gradesta/readable-steno/StenoKiCadProject/production/bom.csv

Designator | Footprint | Quantity | Value | LCSC Part #
C1 | 1206 | 1 | C
D1, D10, D11, D12, D13, D14, D15, D16, D17, D18, D19, D2, D20, D21, D22, D23, D24, D25, D26, D27, D28, D29, D3, D30, D4, D5, D6, D7, D8, D9 | 1206 | 30 | Diode
D31, D32, D33, D34, D35, D36, D37, D38, D39, D40, D41, D42, D43, D44, D45, D46, D47, D48, D49, D50, D51, D52, D53, D54, D55, D56, D57, D58, D59, D60 | 1206 | 30 | LED
J1 | PinHeader_1x04_P2.54mm_Vertical | 1 | Conn_01x04_Pin
R1, R10, R11, R12, R13, R14, R15, R16, R17, R18, R19, R2, R20, R21, R22, R23, R24, R25, R26, R27, R28, R29, R3, R30, R33, R4, R5, R6, R7, R8, R9 | 1206 | 31 | Resistor
S1, S10, S11, S12, S13, S14, S15, S16, S17, S18, S19, S2, S20, S21, S22, S23, S24, S25, S26, S27, S28, S29, S3, S30, S4, S5, S6, S7, S8, S9 | Hotswap_Choc_V1 | 30 | Keyswitch
U1 | RP2040_Pro_Micro | 1 | RP2040_Pro_Micro
U2, U3, U4, U5 | DIP-16_W7.62mm | 4 | 74HC595
