gradesta/readable-steno/StenoKiCadProject/StenKeyboard.kicad_pcb

## KiCad design StenoKiCadProject/StenKeyboard.kicad_pcb (2026-01-27)

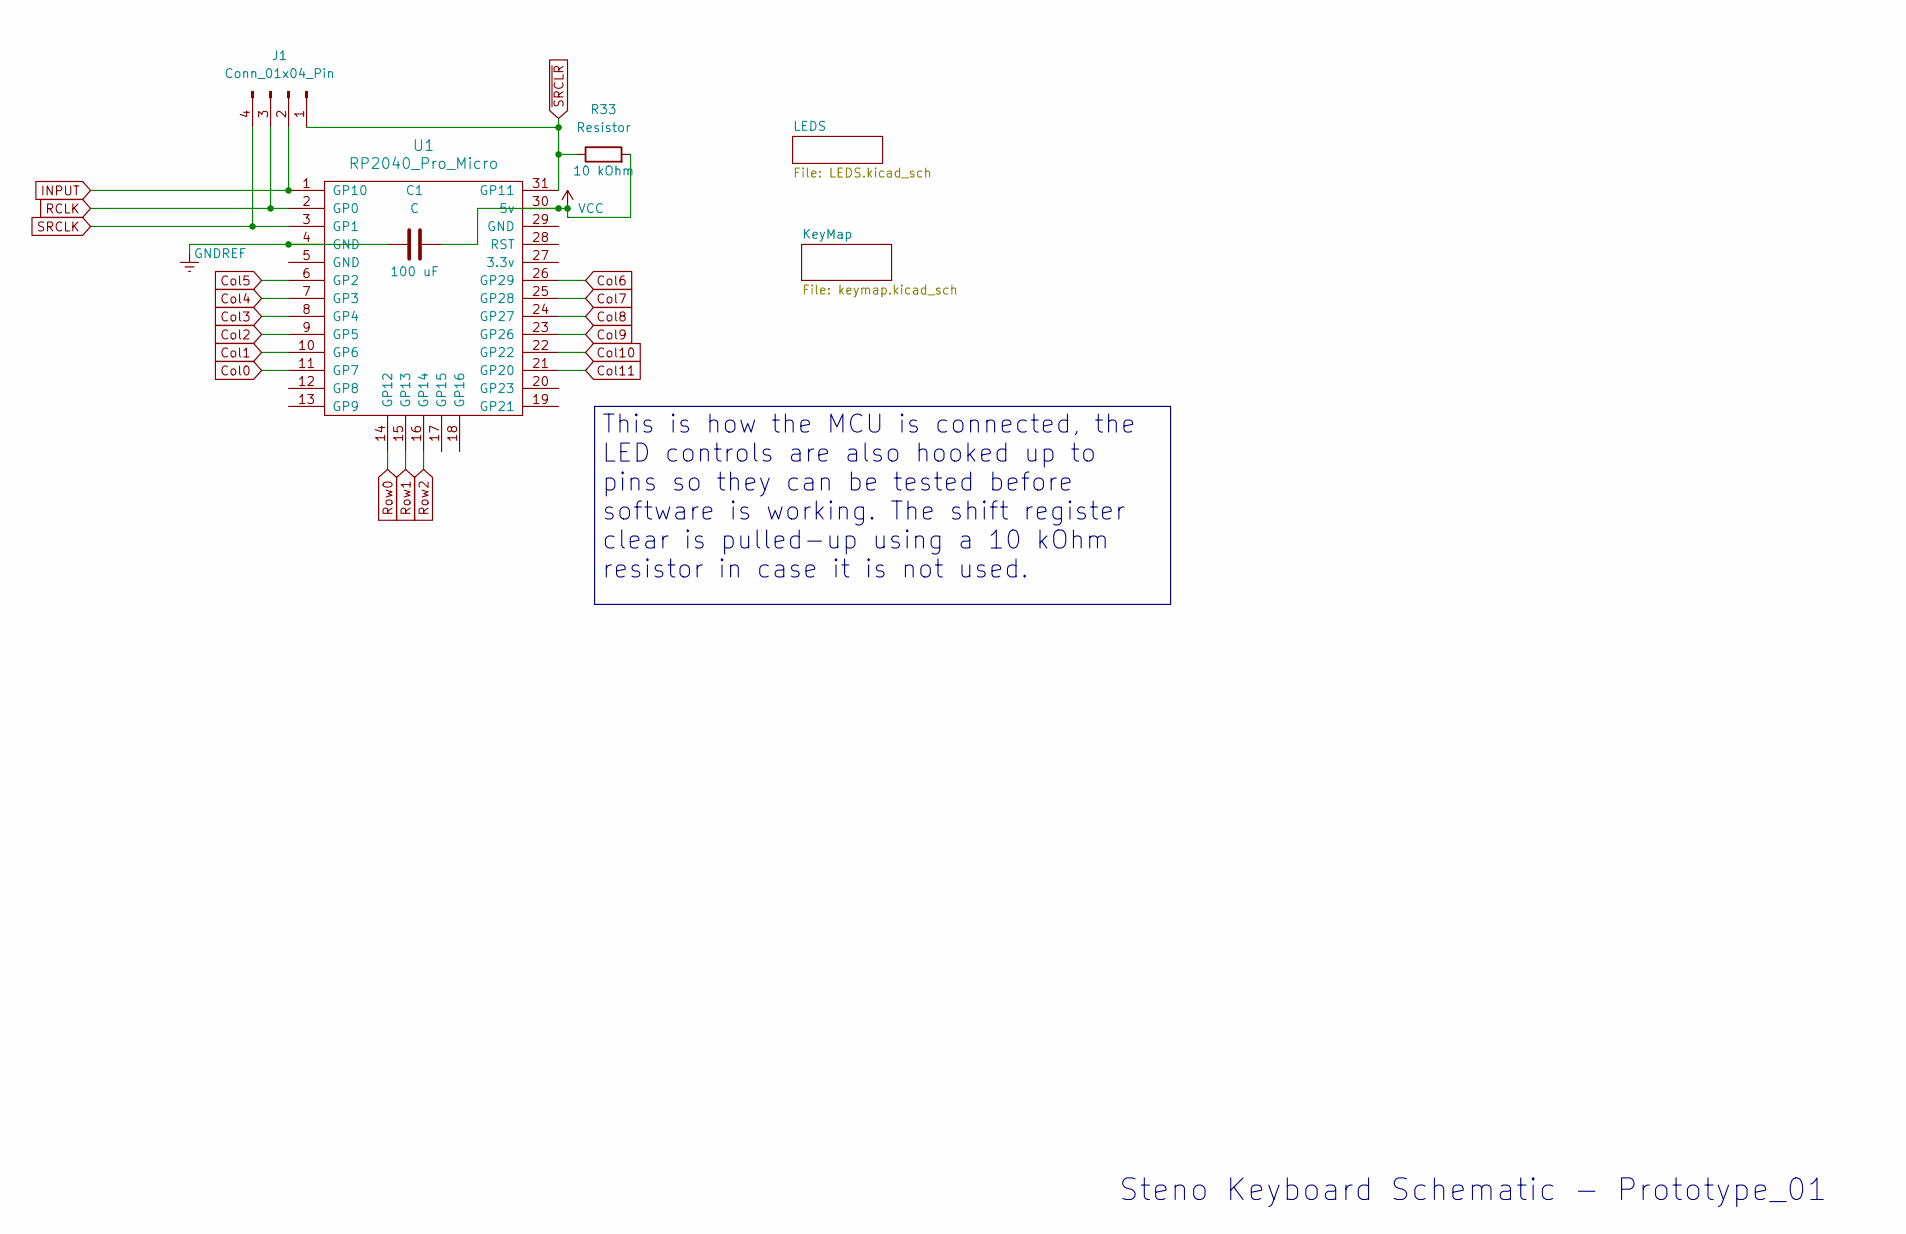
[picture p1: schematic StenKeyboard.kicad_sch]

Parts:
C1: C; C_1206_3216Metric
J1: Conn_01x04_Pin; PinHeader_1x04_P2.54mm_Vertical
R33: Resistor; R_1206_3216Metric
U1: RP2040_Pro_Micro

Connections:
Col0: U1.11 (GP7); also elsewhere on the board
Col1: U1.10 (GP6); also elsewhere on the board
Col2: U1.9 (GP5); also elsewhere on the board
Col3: U1.8 (GP4); also elsewhere on the board
Col4: U1.7 (GP3); also elsewhere on the board
Col5: U1.6 (GP2); also elsewhere on the board
Col6: U1.26 (GP29); also elsewhere on the board
Col7: U1.25 (GP28); also elsewhere on the board
Col8: U1.24 (GP27); also elsewhere on the board
Col9: U1.23 (GP26); also elsewhere on the board
Col10: U1.22 (GP22); also elsewhere on the board
Col11: U1.21 (GP20); also elsewhere on the board
GNDREF: C1.1, U1.4 (GND); also elsewhere on the board
INPUT: J1.2, U1.1 (GP10); also elsewhere on the board
RCLK: J1.3, U1.2 (GP0); also elsewhere on the board
Row0: U1.14 (GP12); also elsewhere on the board
Row1: U1.15 (GP13); also elsewhere on the board
Row2: U1.16 (GP14); also elsewhere on the board
SRCLK: J1.4, U1.3 (GP1); also elsewhere on the board
VCC: C1.2, R33.2, U1.30 (5v); also elsewhere on the board
~SRCLR: J1.1, R33.1, U1.31 (GP11); also elsewhere on the board

Notes on the sheet:
Steno Keyboard Schematic - Prototype_01
This is how the MCU is connected, the LED controls are also hooked up to pins so they can be tested before software is working. The shift register clear is pulled-up using a 10 kOhm resistor in case it is not used.

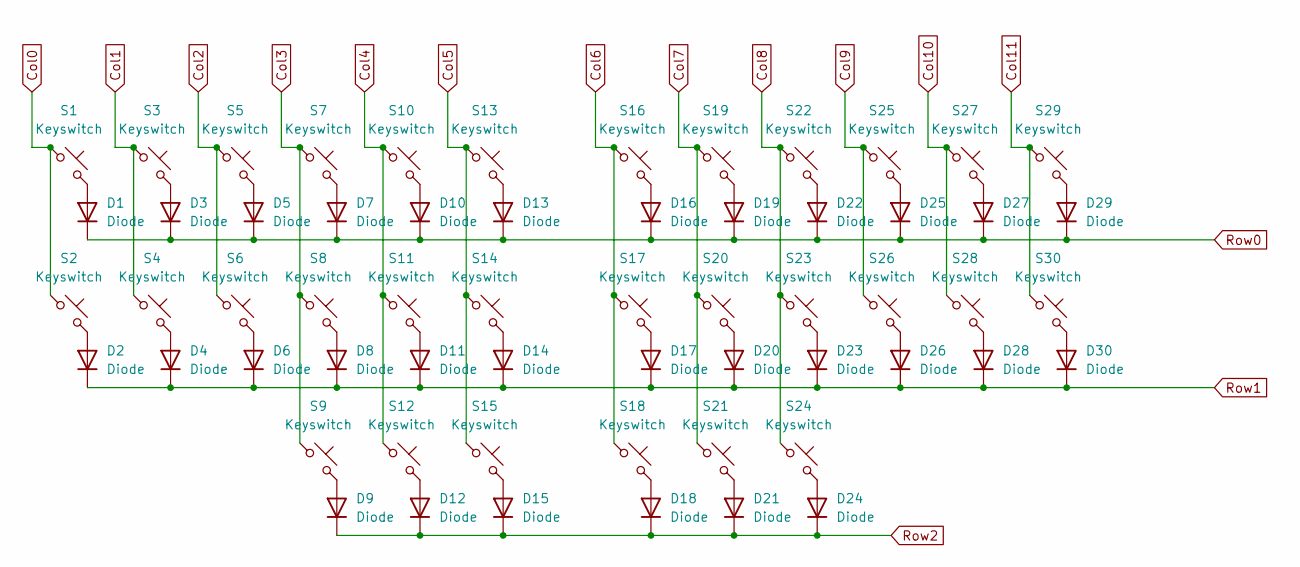
[picture p2: schematic keymap.kicad_sch]

Parts:
D1, D2, D3, D4, D5, D6, D7, D8, D9, D10, D11, D12, D13, D14, D15, D16, D17, D18, D19, D20, D21, D22, D23, D24, D25, D26, D27, D28, D29, D30: Diode; D_1206_3216Metric
S1, S2, S3, S4, S5, S6, S7, S8, S9, S10, S11, S12, S13, S14, S15, S16, S17, S18, S19, S20, S21, S22, S23, S24, S25, S26, S27, S28, S29, S30: Keyswitch; Hotswap_Choc_V1

Connections:
Col0: S1.1, S2.1; also elsewhere on the board
Col1: S3.1, S4.1; also elsewhere on the board
Col2: S5.1, S6.1; also elsewhere on the board
Col3: S7.1, S8.1, S9.1; also elsewhere on the board
Col4: S10.1, S11.1, S12.1; also elsewhere on the board
Col5: S13.1, S14.1, S15.1; also elsewhere on the board
Col6: S16.1, S17.1, S18.1; also elsewhere on the board
Col7: S19.1, S20.1, S21.1; also elsewhere on the board
Col8: S22.1, S23.1, S24.1; also elsewhere on the board
Col9: S25.1, S26.1; also elsewhere on the board
Col10: S27.1, S28.1; also elsewhere on the board
Col11: S29.1, S30.1; also elsewhere on the board
unnamed: D1.2 (A), S1.2
unnamed: D2.2 (A), S2.2
unnamed: D3.2 (A), S3.2
unnamed: D4.2 (A), S4.2
unnamed: D5.2 (A), S5.2
unnamed: D6.2 (A), S6.2
unnamed: D7.2 (A), S7.2
unnamed: D8.2 (A), S8.2
unnamed: D9.2 (A), S9.2
unnamed: D10.2 (A), S10.2
unnamed: D11.2 (A), S11.2
unnamed: D12.2 (A), S12.2
unnamed: D13.2 (A), S13.2
unnamed: D14.2 (A), S14.2
unnamed: D15.2 (A), S15.2
unnamed: D16.2 (A), S16.2
unnamed: D17.2 (A), S17.2
unnamed: D18.2 (A), S18.2
unnamed: D19.2 (A), S19.2
unnamed: D20.2 (A), S20.2
unnamed: D21.2 (A), S21.2
unnamed: D22.2 (A), S22.2
unnamed: D23.2 (A), S23.2
unnamed: D24.2 (A), S24.2
unnamed: D25.2 (A), S25.2
unnamed: D26.2 (A), S26.2
unnamed: D27.2 (A), S27.2
unnamed: D28.2 (A), S28.2
unnamed: D29.2 (A), S29.2
unnamed: D30.2 (A), S30.2
Row0: D1.1 (K), D3.1 (K), D5.1 (K), D7.1 (K), D10.1 (K), D13.1 (K), D16.1 (K), D19.1 (K), D22.1 (K), D25.1 (K), D27.1 (K), D29.1 (K); also elsewhere on the board
Row1: D2.1 (K), D4.1 (K), D6.1 (K), D8.1 (K), D11.1 (K), D14.1 (K), D17.1 (K), D20.1 (K), D23.1 (K), D26.1 (K), D28.1 (K), D30.1 (K); also elsewhere on the board
Row2: D9.1 (K), D12.1 (K), D15.1 (K), D18.1 (K), D21.1 (K), D24.1 (K); also elsewhere on the board

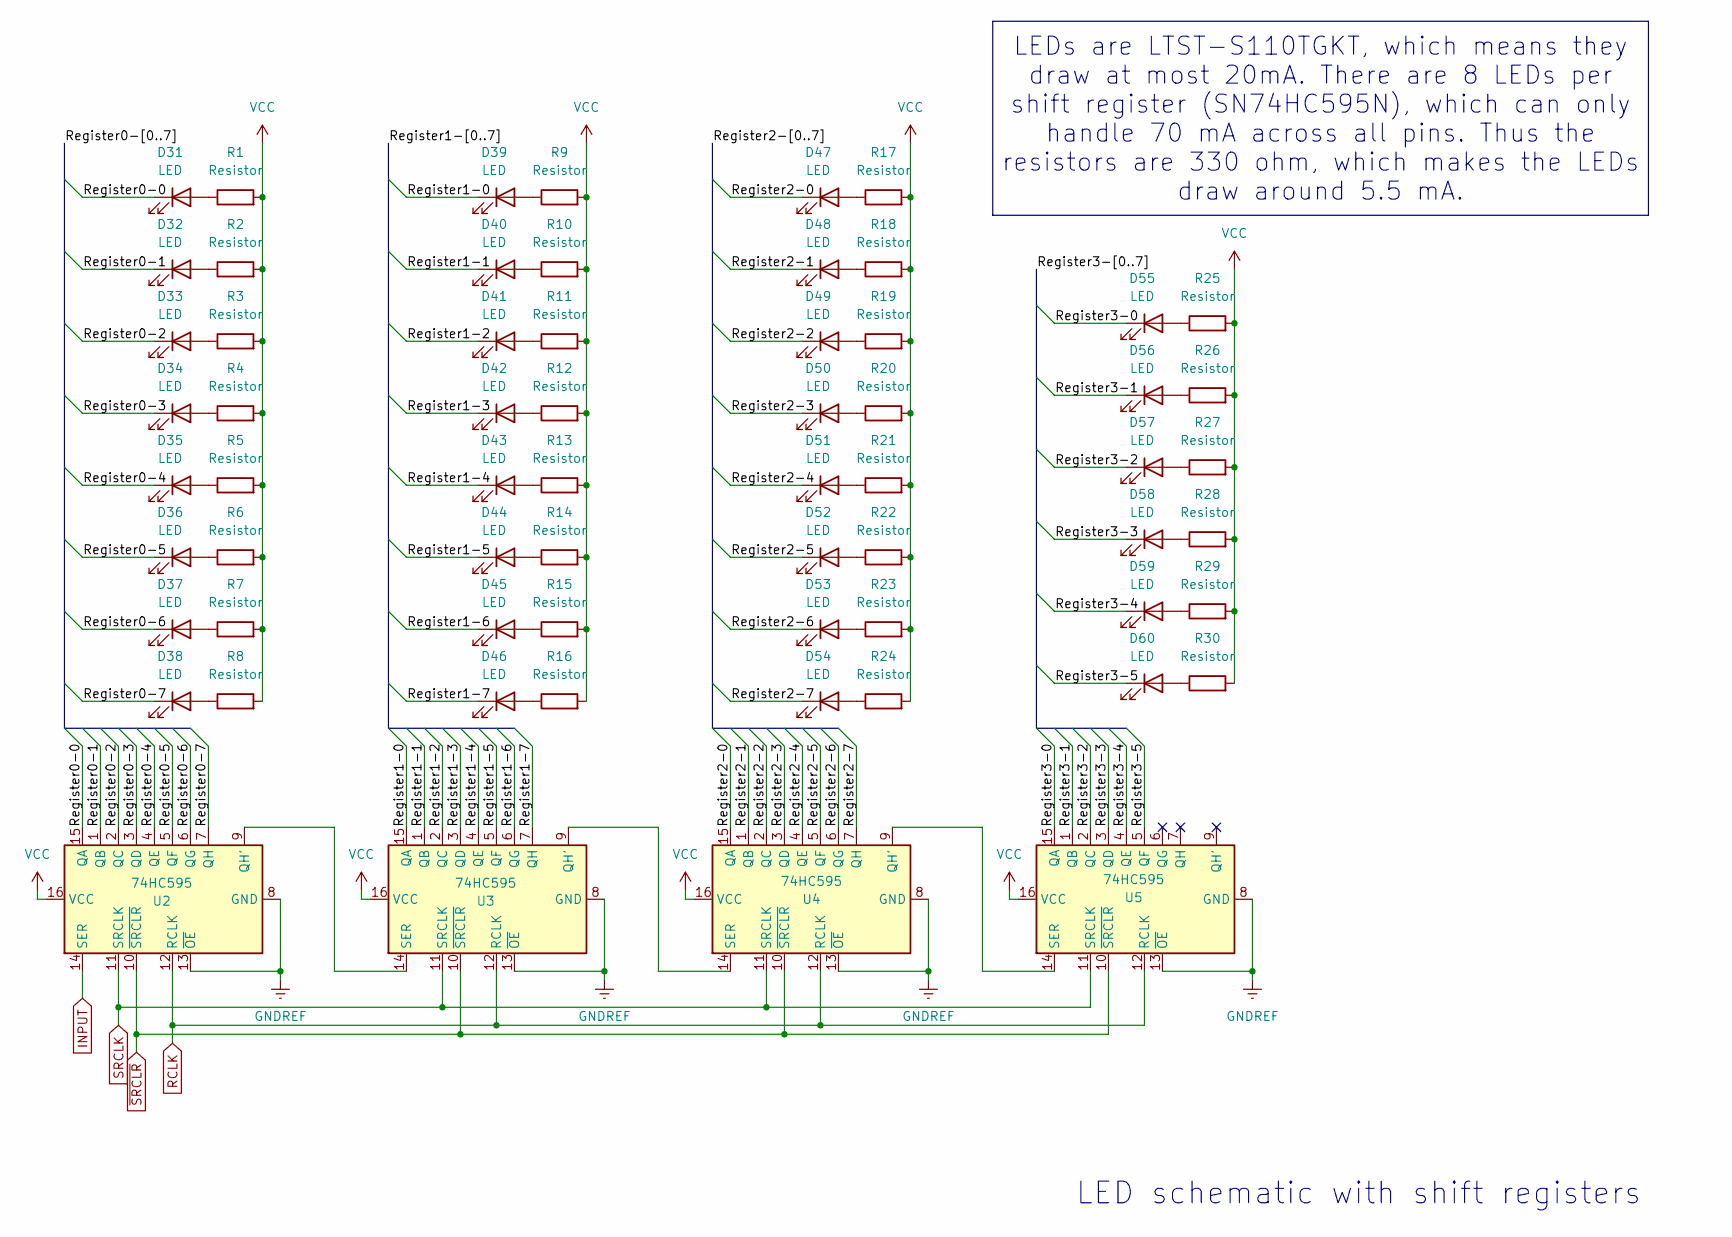
[picture p3: schematic LEDS.kicad_sch]

Parts:
D31, D32, D33, D34, D35, D36, D37, D38, D39, D40, D41, D42, D43, D44, D45, D46, D47, D48, D49, D50, D51, D52, D53, D54, D55, D56, D57, D58, D59, D60: LED; LED_1206_3216Metric
R1, R2, R3, R4, R5, R6, R7, R8, R9, R10, R11, R12, R13, R14, R15, R16, R17, R18, R19, R20, R21, R22, R23, R24, R25, R26, R27, R28, R29, R30: Resistor; R_1206_3216Metric
U2, U3, U4, U5: 74HC595; DIP-16_W7.62mm

Connections:
/LEDS/Register0-0: D31.1 (K), U2.15 (QA)
/LEDS/Register0-1: D32.1 (K), U2.1 (QB)
/LEDS/Register0-2: D33.1 (K), U2.2 (QC)
/LEDS/Register0-3: D34.1 (K), U2.3 (QD)
/LEDS/Register0-4: D35.1 (K), U2.4 (QE)
/LEDS/Register0-5: D36.1 (K), U2.5 (QF)
/LEDS/Register0-6: D37.1 (K), U2.6 (QG)
/LEDS/Register0-7: D38.1 (K), U2.7 (QH)
/LEDS/Register1-0: D39.1 (K), U3.15 (QA)
/LEDS/Register1-1: D40.1 (K), U3.1 (QB)
/LEDS/Register1-2: D41.1 (K), U3.2 (QC)
/LEDS/Register1-3: D42.1 (K), U3.3 (QD)
/LEDS/Register1-4: D43.1 (K), U3.4 (QE)
/LEDS/Register1-5: D44.1 (K), U3.5 (QF)
/LEDS/Register1-6: D45.1 (K), U3.6 (QG)
/LEDS/Register1-7: D46.1 (K), U3.7 (QH)
/LEDS/Register2-0: D47.1 (K), U4.15 (QA)
/LEDS/Register2-1: D48.1 (K), U4.1 (QB)
/LEDS/Register2-2: D49.1 (K), U4.2 (QC)
/LEDS/Register2-3: D50.1 (K), U4.3 (QD)
/LEDS/Register2-4: D51.1 (K), U4.4 (QE)
/LEDS/Register2-5: D52.1 (K), U4.5 (QF)
/LEDS/Register2-6: D53.1 (K), U4.6 (QG)
/LEDS/Register2-7: D54.1 (K), U4.7 (QH)
/LEDS/Register3-0: D55.1 (K), U5.15 (QA)
/LEDS/Register3-1: D56.1 (K), U5.1 (QB)
/LEDS/Register3-2: D57.1 (K), U5.2 (QC)
/LEDS/Register3-3: D58.1 (K), U5.3 (QD)
/LEDS/Register3-4: D59.1 (K), U5.4 (QE)
/LEDS/Register3-5: D60.1 (K), U5.5 (QF)
GNDREF: U2.8 (GND), U2.13 (~OE), U3.8 (GND), U3.13 (~OE), U4.8 (GND), U4.13 (~OE), U5.8 (GND), U5.13 (~OE); also elsewhere on the board
INPUT: U2.14 (SER); also elsewhere on the board
unnamed: D31.2 (A), R1.1
unnamed: D32.2 (A), R2.1
unnamed: D33.2 (A), R3.1
unnamed: D34.2 (A), R4.1
unnamed: D35.2 (A), R5.1
unnamed: D36.2 (A), R6.1
unnamed: D37.2 (A), R7.1
unnamed: D38.2 (A), R8.1
unnamed: D39.2 (A), R9.1
unnamed: D40.2 (A), R10.1
unnamed: D41.2 (A), R11.1
unnamed: D42.2 (A), R12.1
unnamed: D43.2 (A), R13.1
unnamed: D44.2 (A), R14.1
unnamed: D45.2 (A), R15.1
unnamed: D46.2 (A), R16.1
unnamed: D47.2 (A), R17.1
unnamed: D48.2 (A), R18.1
unnamed: D49.2 (A), R19.1
unnamed: D50.2 (A), R20.1
unnamed: D51.2 (A), R21.1
unnamed: D52.2 (A), R22.1
unnamed: D53.2 (A), R23.1
unnamed: D54.2 (A), R24.1
unnamed: D55.2 (A), R25.1
unnamed: D56.2 (A), R26.1
unnamed: D57.2 (A), R27.1
unnamed: D58.2 (A), R28.1
unnamed: D59.2 (A), R29.1
unnamed: D60.2 (A), R30.1
unnamed: U2.9 (QH'), U3.14 (SER)
unnamed: U3.9 (QH'), U4.14 (SER)
unnamed: U4.9 (QH'), U5.14 (SER)
RCLK: U2.12 (RCLK), U3.12 (RCLK), U4.12 (RCLK), U5.12 (RCLK); also elsewhere on the board
SRCLK: U2.11 (SRCLK), U3.11 (SRCLK), U4.11 (SRCLK), U5.11 (SRCLK); also elsewhere on the board
VCC: R1.2, R2.2, R3.2, R4.2, R5.2, R6.2, R7.2, R8.2, R9.2, R10.2, R11.2, R12.2, R13.2, R14.2, R15.2, R16.2, R17.2, R18.2, R19.2, R20.2, R21.2, R22.2, R23.2, R24.2, R25.2, R26.2, R27.2, R28.2, R29.2, R30.2, U2.16 (VCC), U3.16 (VCC), U4.16 (VCC), U5.16 (VCC); also elsewhere on the board
~SRCLR: U2.10 (~SRCLR), U3.10 (~SRCLR), U4.10 (~SRCLR), U5.10 (~SRCLR); also elsewhere on the board

Notes on the sheet:
LED schematic with shift registers
LEDs are LTST-S110TGKT, which means they draw at most 20mA. There are 8 LEDs per shift register (SN74HC595N), which can only handle 70 mA across all pins. Thus the resistors are 330 ohm, which makes the LEDs draw around 5.5 mA.

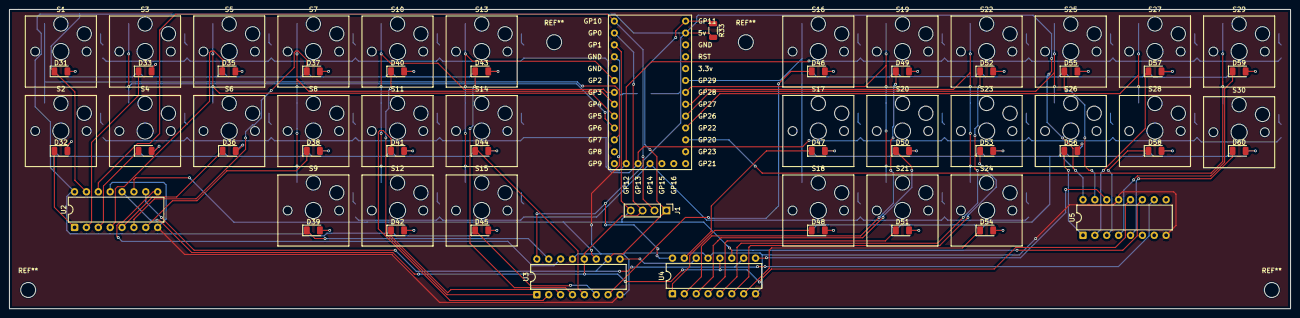
[picture p4: board StenKeyboard.kicad_pcb from above]

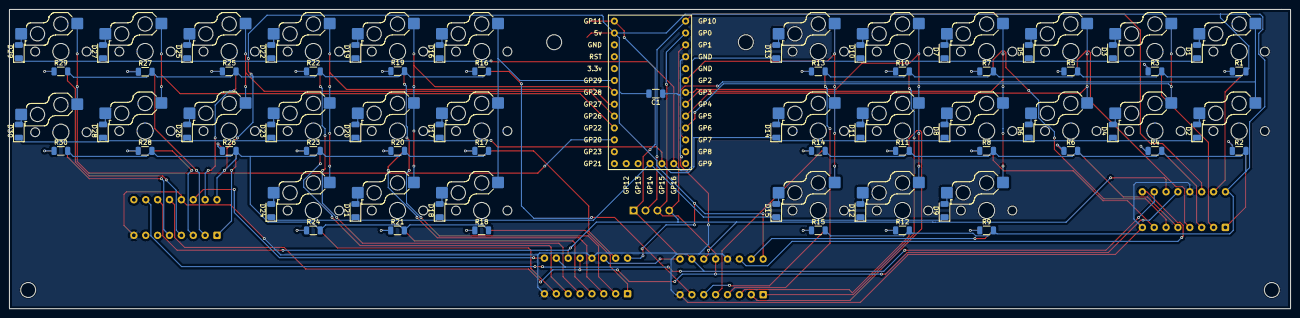
[picture p5: board StenKeyboard.kicad_pcb from below]

Board: 2 copper layers, 274.0 x 64.0 mm, 128 parts (61 on the bottom side), 114 nets.
