gradesta/readable-steno/dev_log/#2-14_07_2025-18_07_2025.md

# Dev log #2 | 14.07.2025 - 18.07.2025

## Soldering first prototype
While some of the parts have already arrived, we are still waiting for the LEDs and other passive components. In this time, the components we have, which are the hot-swap sockets, diodes and some shift registers from previous projects were soldered onto the PCB.
k1
k2
k3

The pins for the liatris controller have also been soldered.
k4

## First software
To test whether the keyboard was working. We decided to insert the keys into the hot swap sockets and try to load javelin onto the board. We followed the steps in the [javelin-steno-pico](https://github.com/jthlim/javelin-steno-pico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) repository. The new config file can be found in this repository or using [this link](https://github.com/gradesta/readable-steno/blob/main/config/readable_steno.h). We managed to get the keyboard to output steno data and after using the javelin steno tools found [here](https://lim.au/#/software/javelin-steno-tools), under the script tool we could edit the characters of individual keys. Now the board can be used as a traditional steno input device and the focus will start to shift to reading data from the computer.
