gradesta/readable-steno/dev_log/#1-30_06_2025-11_7_2025.md

# Dev log #1 | 30.06.2025 - 11.07.2025

## Started prototype development
The first prototype board is mainly focused for software development.
There are LEDs to signal which keys make up the current word. It uses the Liatris microcontroller, which has the RP2040 microchip and 16MB of flash memory, so javelin can be installed on it.



### Keymap

In the schematic the keyboard uses a standard keyboard matrix, it has 30 keys and is connected to a `rp2040 pro micro`. This board is designed to use hot swap sockets, so a broken switch is easily replaceable and low profile Choc switches.

### LEDs

For the LEDs there are 4 `SN74HC595N` shift registers, because there are not enough pins to control them individually. The sift register pins SRCLR are also pulled up high to not reset the storage, but also connected to gpio so we can still use them if we want to.
The LEDs are connected in a way, where the shift register sinks the current on the cathode, while the anode is permanently
connected with 330Ω to the 5V Raw pin on the MCU. There are also 4 break-out pins, so the leds can be tested either with buttons or an external MCU.



## Material list
### Required
- 1 x [Liatris Microcontroller](https://splitkb.com/products/liatris?_pos=1&_sid=461909dce&_ss=r)
- 30 x [Kingbright APT3216LZGCK smd green led](https://lcsc.com/product-detail/LED-Indication-Discrete_Kingbright-APT3216LZGCK_C5569481.html)
- 30 x [YAGEO RC1206FR-07330RL 330Ω smd resistor](https://lcsc.com/product-detail/Chip-Resistor-Surface-Mount_YAGEO-RC1206FR-07330RL_C114944.html)
- 1 x [UNI-ROYAL(Uniroyal Elec) 1206W4F1002T5E 10kΩ smd pull-up resistor](https://lcsc.com/product-detail/Chip-Resistor-Surface-Mount_UNI-ROYAL-Uniroyal-Elec-1206W4F1002T5E_C17902.html)
- 4 x [Texas Instruments SN74HC595N shift register](https://lcsc.com/product-detail/Shift-Registers_Texas-Instruments-SN74HC595N_C78711.html)
- 1 x [Samsung Electro-Mechanics CL31A107MQHNNNE 100μF smd capacitor](https://lcsc.com/product-detail/Multilayer-Ceramic-Capacitors-MLCC-SMD-SMT_Samsung-Electro-Mechanics-CL31A107MQHNNNE_C15008.html)
- 1 x [XFCN PZ254V-11-04P pin headers](https://lcsc.com/product-detail/Pin-Headers_XFCN-PZ254V-11-04P_C2691448.html)
- 30 x [Kailh Low Profile Choc Switches](https://splitkb.com/products/kailh-low-profile-choc-switches)
- 30 x [Kailh Choc Hotswap sockets](https://splitkb.com/products/kailh-hotswap-sockets?variant=39472161456205)

### Optional
- Optionally you can use [pin sockets](https://lcsc.com/product-detail/Female-Headers_HCTL-PM254-1-13-Z-3-0-C_C5159941.html) for the MCU, so it is not directly solder onto the keyboard
