gradesta/readable-steno/(commit log)

2025-07-09 feat: Uploaded gerber file
2025-07-09 fix: Added missing component to material list
2025-08-08 Added dev log and code for leds
2025-08-17 Updated read code to use serial communication, fixed bugs in translator.py
    [led_driver.c, led_driver.h, main.c, translator.py, tusb_config.h]
2025-10-11 Updated .gitignore, updated README and added gerber for testing board for coils
2026-01-27 Added KiCAD project files
